MunFaDor/Ddiploma_Project/Traffic_Light_test_triple_LED.SLDPRT

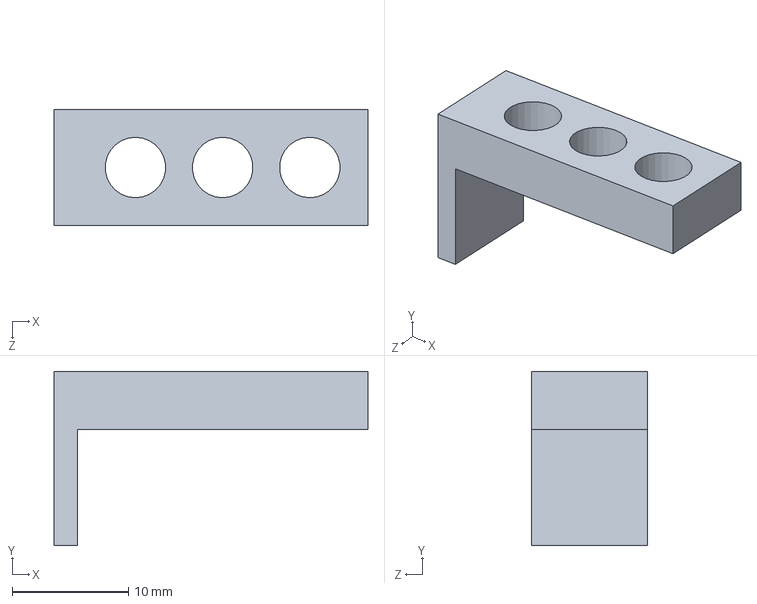
[picture p39: CAD file, 2024-04-10]
Traffic_Light_test_triple_LED.SLDPRT
27.0 x 15.0 x 10.0 mm
