MunFaDor/Ddiploma_Project/Traffic_Light_check_hole_LED.SLDPRT

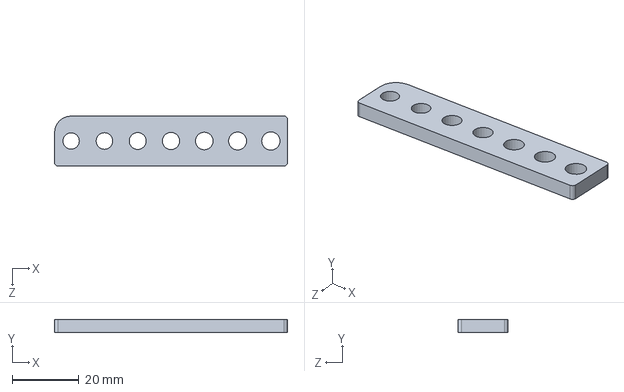
[picture p40: CAD file, 2024-04-10]
Traffic_Light_check_hole_LED.SLDPRT
70.0 x 4.00 x 15.0 mm
