MunFaDor/Ddiploma_Project/Traffic_Light_supporters_pcb_type2_pin_platers.SLDPRT

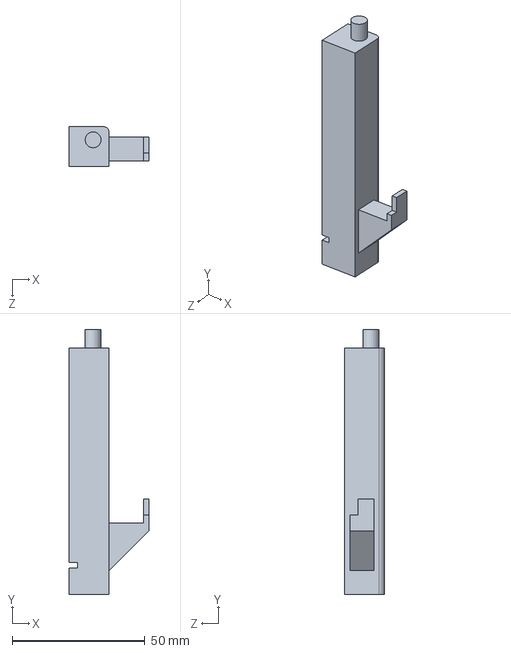
[picture p41: CAD file, 2024-04-10]
Traffic_Light_supporters_pcb_type2_pin_platers.SLDPRT
30.0 x 100.0 x 15.0 mm
