MunFaDor/Ddiploma_Project/Traffic_Light_supporters_type1.SLDPRT

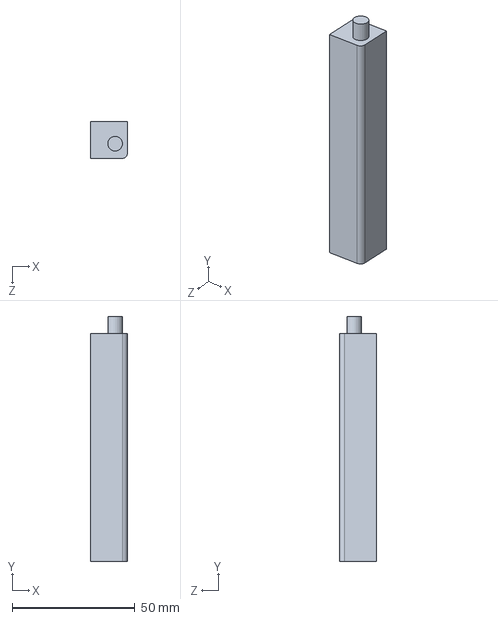
[picture p43: CAD file, 2024-04-10]
Traffic_Light_supporters_type1.SLDPRT
15.0 x 100.0 x 15.0 mm
