MunFaDor/Ddiploma_Project/Traffic_Light_check_hole_button.SLDPRT

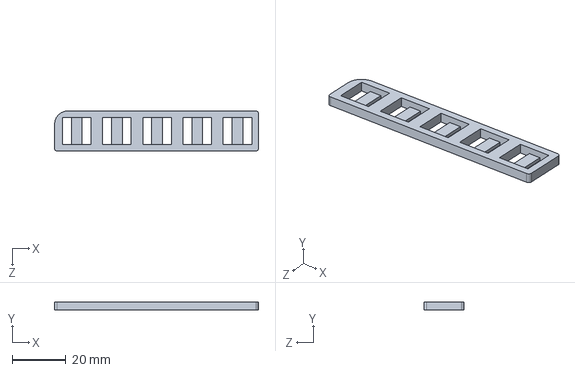
[picture p44: CAD file, 2024-04-10]
Traffic_Light_check_hole_button.SLDPRT
76.1 x 3.00 x 15.0 mm
