MunFaDor/Ddiploma_Project/Traffic_Light_check_supports_hole.SLDPRT

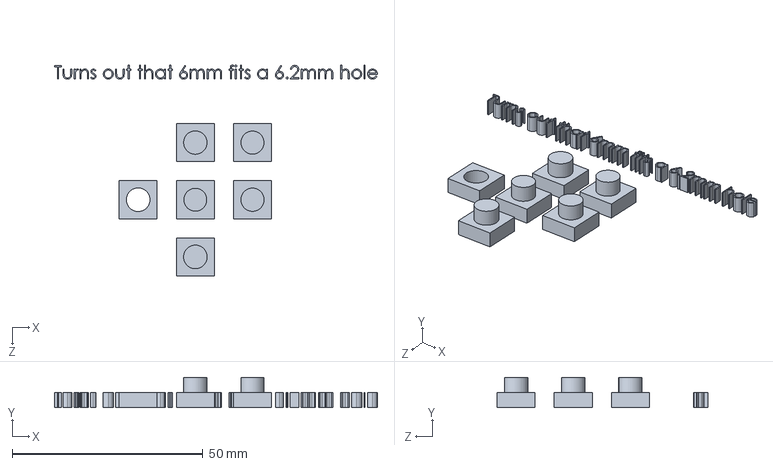
[picture p45: CAD file, 2024-04-10]
Traffic_Light_check_supports_hole.SLDPRT
84.8 x 8.00 x 55.3 mm
