MunFaDor/Ddiploma_Project/Traffic_Light_supporters_pcb_type1_pin_platers.SLDPRT

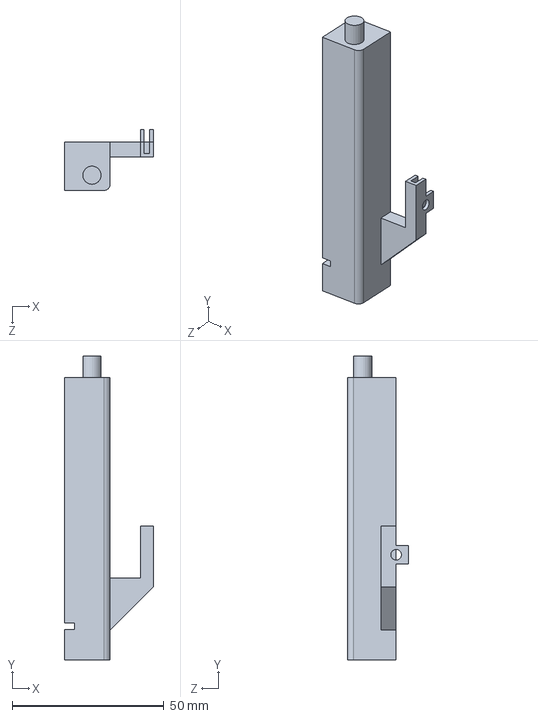
[picture p46: CAD file, 2024-04-10]
Traffic_Light_supporters_pcb_type1_pin_platers.SLDPRT
29.2 x 100.0 x 20.0 mm
