MunFaDor/Ddiploma_Project/Traffic_Light_pcb_mockup.SLDPRT

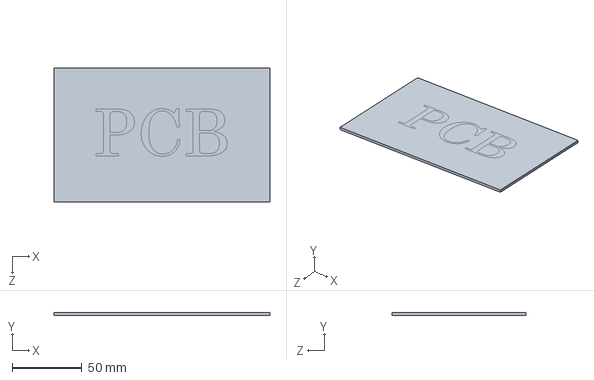
[picture p47: CAD file, 2024-04-10]
Traffic_Light_pcb_mockup.SLDPRT
155.0 x 2.00 x 96.0 mm
