MunFaDor/Ddiploma_Project/Traffic_Light_piece.SLDPRT

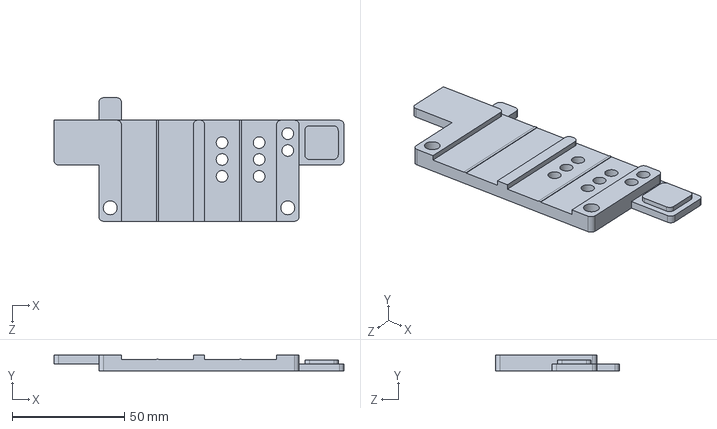
[picture p48: CAD file, 2024-04-10]
Traffic_Light_piece.SLDPRT
129.0 x 7.00 x 55.0 mm
