MunFaDor/Ddiploma_Project/Traffic_Light_piece_center.SLDPRT

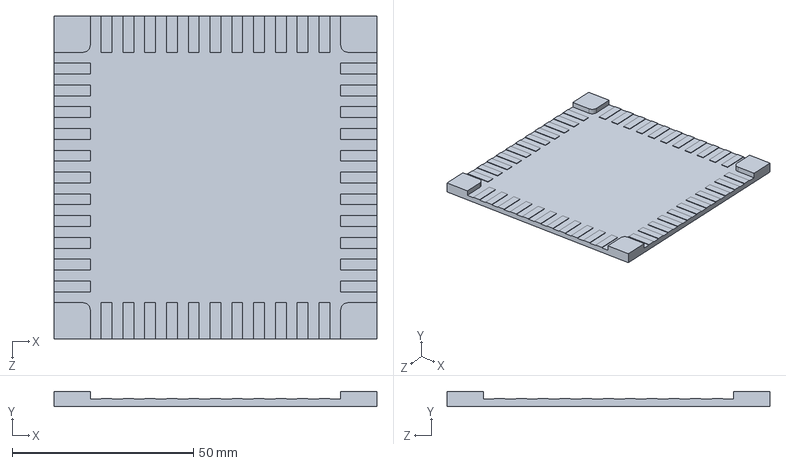
[picture p49: CAD file, 2024-04-10]
Traffic_Light_piece_center.SLDPRT
89.0 x 4.00 x 89.0 mm
