MunFaDor/Ddiploma_Project/(list of files, cad)

Other CAD files:
Traffic_Light_supporters_type2.SLDPRT
Traffic_Light_supporters_pcb_type1.SLDPRT
